tadashinagashima/certificadora-dois/hardware/mecanica/exportacoes/prancha_dimensional.pdf

# TABULEIRO DE XADREZ SENSORIAL

MEC-01 / Estudo dimensional paramétrico - unidades em mm - configuração inicial de protótipo

## A. MDF SUPERIOR SEM VIDRO / PLANTA

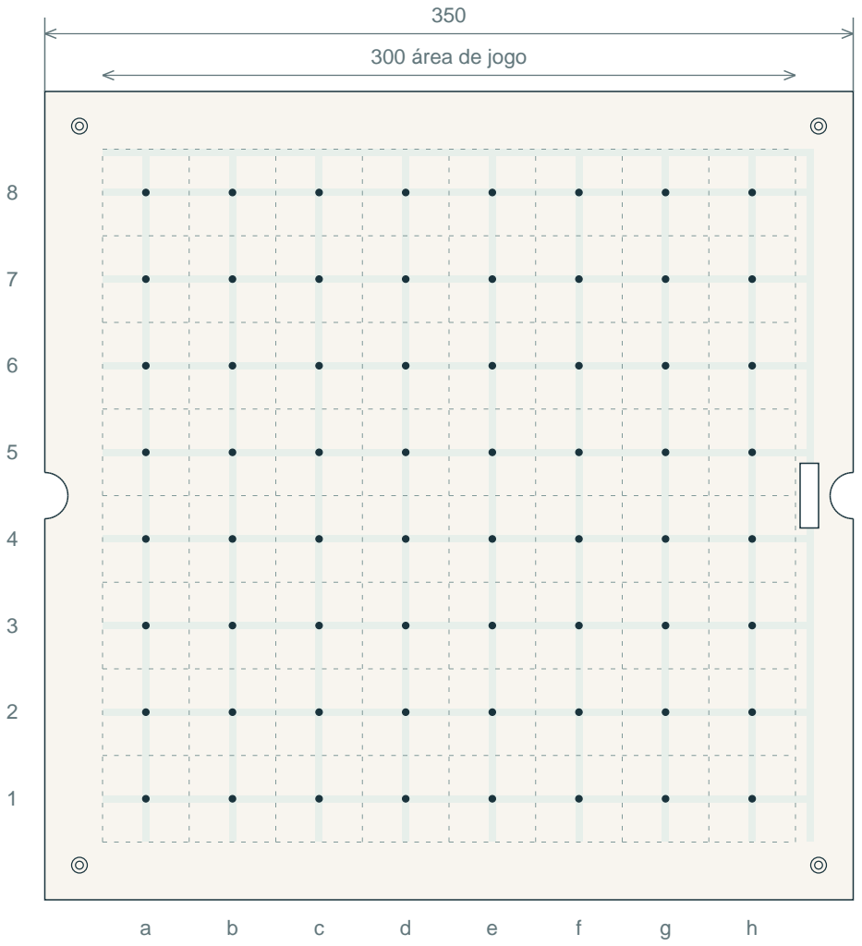
[picture p1: figure]
300 área de jogo

LADO DAS BRANCAS / Y MÍNIMO

350

64 × Ø2,8 passantes

Eixos: 43,75 + n × 37,5
n = 0...7, nos eixos X e Y.

### 16 canais 3 × 2 + 2 coletores

Fios isolados e soldas abaixo do apoio. Cruzamentos: isolar redes distintas.

Saída do chicote: 8 × 28

X = 327...335 / Y = 161...189

4 × Ø3,4 + escareado Ø6,8

Escareado 90° / profundidade 1,7 Centros 15 mm de cada borda.

### 2 pegas laterais R10 no suporte

Centro Y = 175; vidro continua inteiro.

A1 = (43,75; 43,75)
H8 = (306,25; 306,25)

## B. DETALHE DE UMA CASA / CORTE

Ímã ferrite Ø12 × 3

Vidro 3
Canal 3 × 2
MDF 6
Cola quente inferior

Reed vertical Ø2 × 14 (hipótese)

3

Distância vidro / topo do corpo = 3.
Centro do corpo 10 abaixo do vidro.
Local do contato e campo magnético NÃO simulados. Folga placa / terminal reto = 7; confirmar soldas/cabos. Ensaio obrigatório de uma casa antes de repetir 64.

## C. FRENTE E ACESSOS

60

Botões Ø12: X=65 / 175 / 285; LEDs Ø5: X=115 / 235.
Centro Z=28. Abertura lateral direita 70 × 20; origem Y=140, Z=9.

ESTRUTURA / COTAS VERTICAIS

Fundo 6; paredes 9; suporte superior 6; junta instalada 1; vidro 3.
Altura da caixa 60; altura com pés 63. Travessa central entre colunas d/e.
Vidro nominal350 ×350: confirmar a dimensão real da peça já disponível.
Fixação com cabeça embutida; confirmar parafuso, comprimento e resistência do MDF.

### ESTUDO DE PROTÓTIPO - NÃO LIBERADO PARA FABRICAÇÃO

Validado por software: sólidos, interferências dos envelopes e recomputação paramétrica. Não valida rigidez, tolerâncias nem acionamento magnético.

A3 / 01

Sem escala de impressão garantida
