tadashinagashima/certificadora-dois/hardware/mecanica/exportacoes/coordenadas_sensores.csv

casa | coluna | linha | x_mm | y_mm | z_eixo_mm | eixo_reed
a1 | 0 | 0 | 43.75 | 43.75 | 47.0 | Z
b1 | 1 | 0 | 81.25 | 43.75 | 47.0 | Z
c1 | 2 | 0 | 118.75 | 43.75 | 47.0 | Z
d1 | 3 | 0 | 156.25 | 43.75 | 47.0 | Z
e1 | 4 | 0 | 193.75 | 43.75 | 47.0 | Z
f1 | 5 | 0 | 231.25 | 43.75 | 47.0 | Z
g1 | 6 | 0 | 268.75 | 43.75 | 47.0 | Z
h1 | 7 | 0 | 306.25 | 43.75 | 47.0 | Z
a2 | 0 | 1 | 43.75 | 81.25 | 47.0 | Z
b2 | 1 | 1 | 81.25 | 81.25 | 47.0 | Z
c2 | 2 | 1 | 118.75 | 81.25 | 47.0 | Z
d2 | 3 | 1 | 156.25 | 81.25 | 47.0 | Z
e2 | 4 | 1 | 193.75 | 81.25 | 47.0 | Z
f2 | 5 | 1 | 231.25 | 81.25 | 47.0 | Z
g2 | 6 | 1 | 268.75 | 81.25 | 47.0 | Z
h2 | 7 | 1 | 306.25 | 81.25 | 47.0 | Z
a3 | 0 | 2 | 43.75 | 118.75 | 47.0 | Z
b3 | 1 | 2 | 81.25 | 118.75 | 47.0 | Z
c3 | 2 | 2 | 118.75 | 118.75 | 47.0 | Z
d3 | 3 | 2 | 156.25 | 118.75 | 47.0 | Z
e3 | 4 | 2 | 193.75 | 118.75 | 47.0 | Z
f3 | 5 | 2 | 231.25 | 118.75 | 47.0 | Z
g3 | 6 | 2 | 268.75 | 118.75 | 47.0 | Z
h3 | 7 | 2 | 306.25 | 118.75 | 47.0 | Z
a4 | 0 | 3 | 43.75 | 156.25 | 47.0 | Z
b4 | 1 | 3 | 81.25 | 156.25 | 47.0 | Z
c4 | 2 | 3 | 118.75 | 156.25 | 47.0 | Z
d4 | 3 | 3 | 156.25 | 156.25 | 47.0 | Z
e4 | 4 | 3 | 193.75 | 156.25 | 47.0 | Z
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
