tadashinagashima/certificadora-dois/hardware/eletronica/exports/preview-1.png

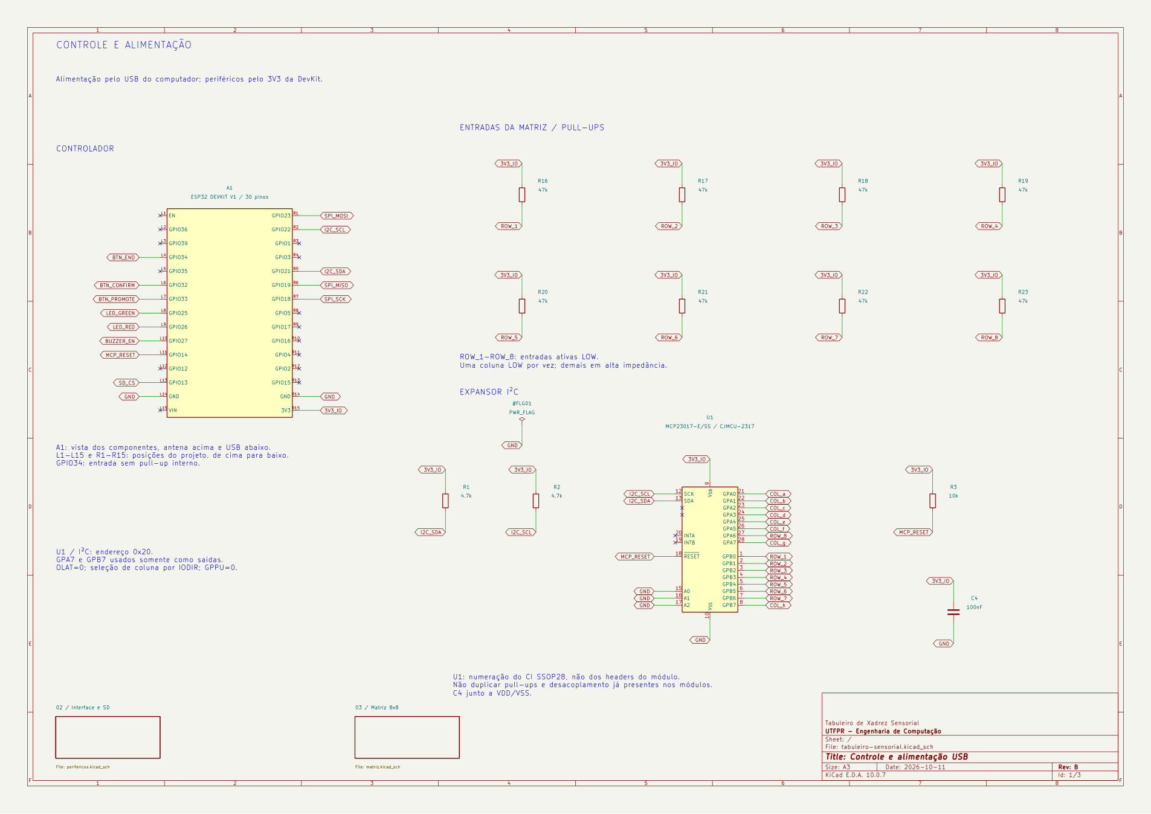
hardware/eletronica/exports/preview-1.png
