tadashinagashima/certificadora-dois/hardware/eletronica/exports/preview-2.png

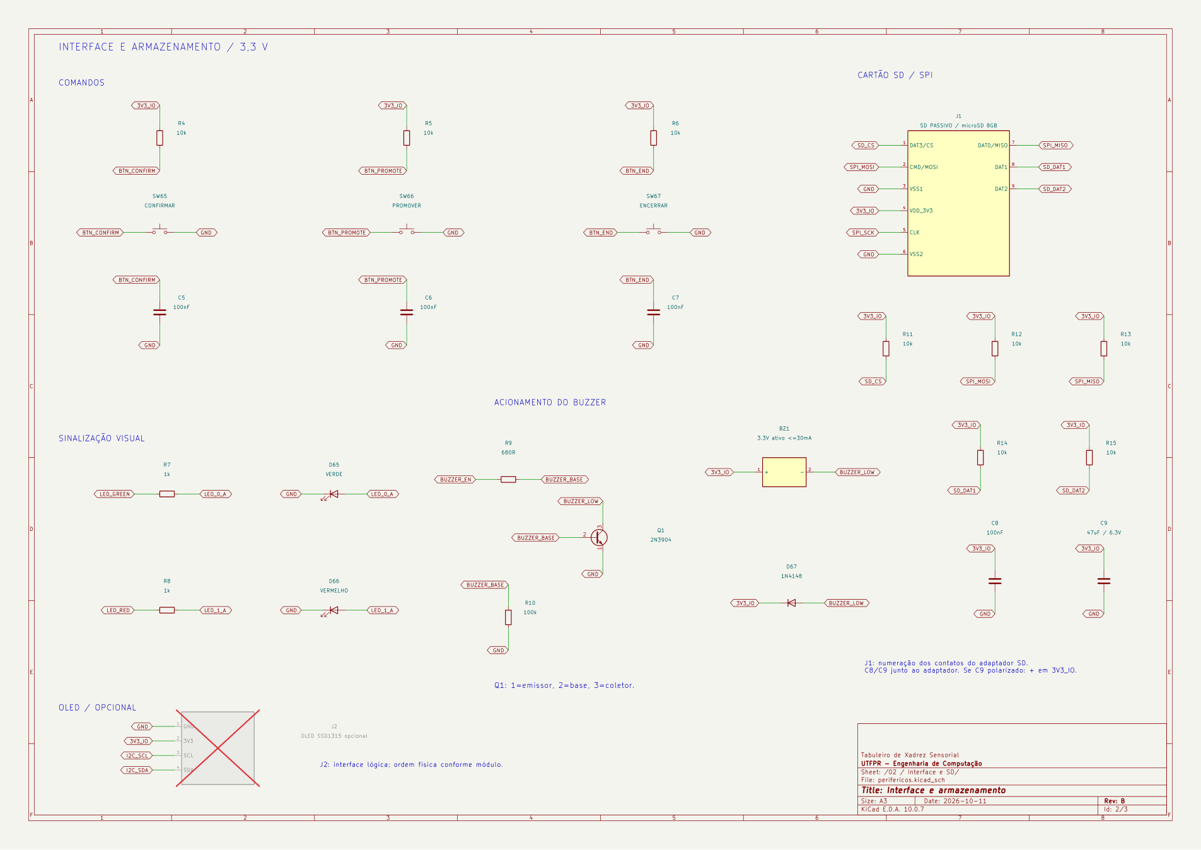
hardware/eletronica/exports/preview-2.png
