tadashinagashima/certificadora-dois/hardware/eletronica/exports/preview-3.png

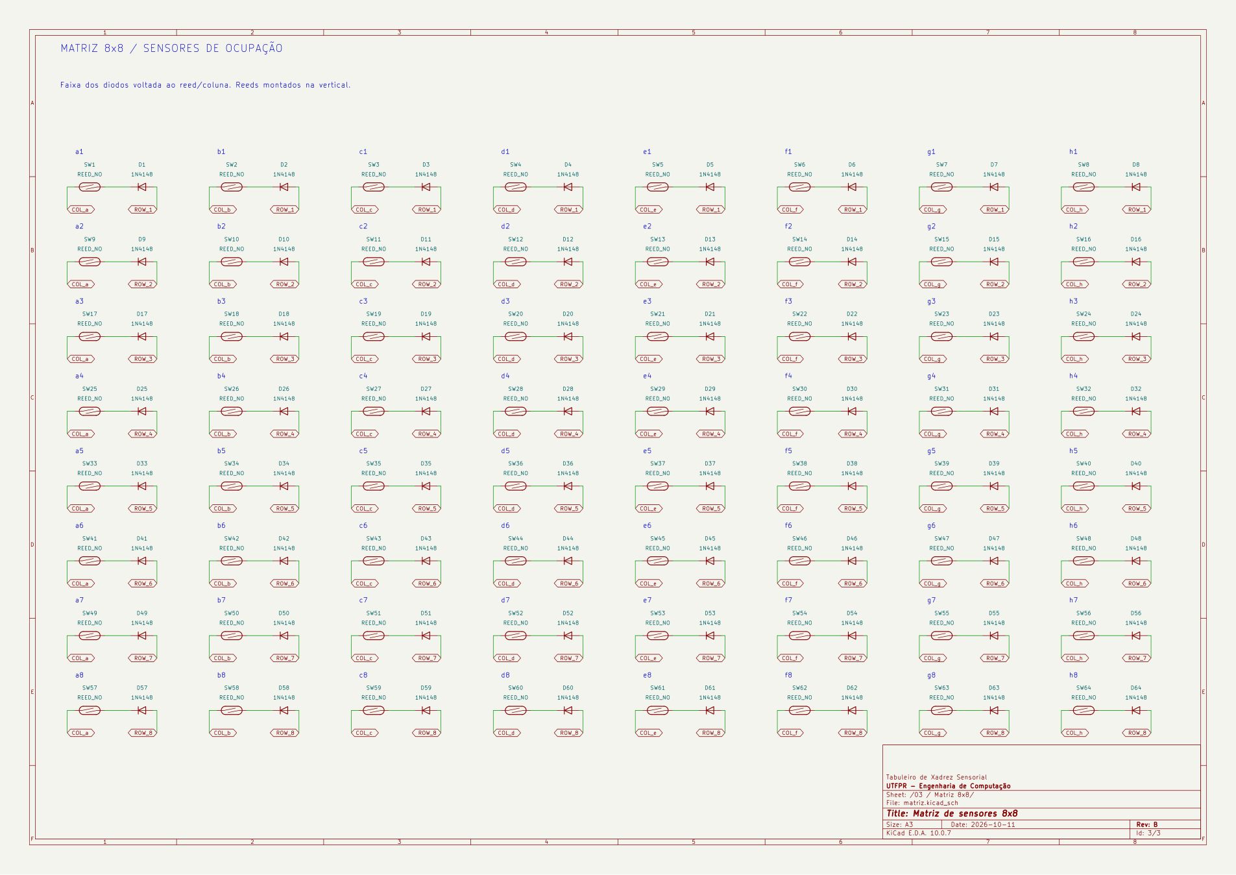
hardware/eletronica/exports/preview-3.png
