tadashinagashima/certificadora-dois/hardware/mecanica/exportacoes/matriz_inferior.png

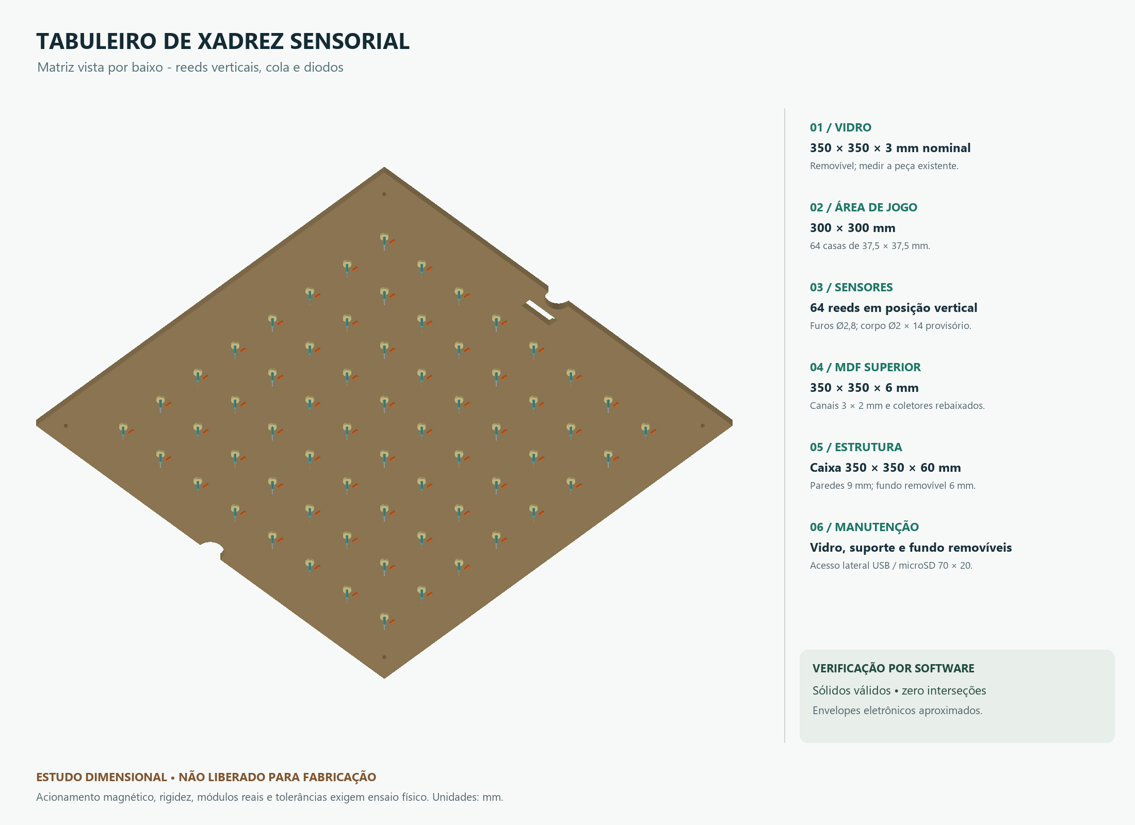
hardware/mecanica/exportacoes/matriz_inferior.png
