tadashinagashima/certificadora-dois/hardware/mecanica/exportacoes/vista_explodida.png

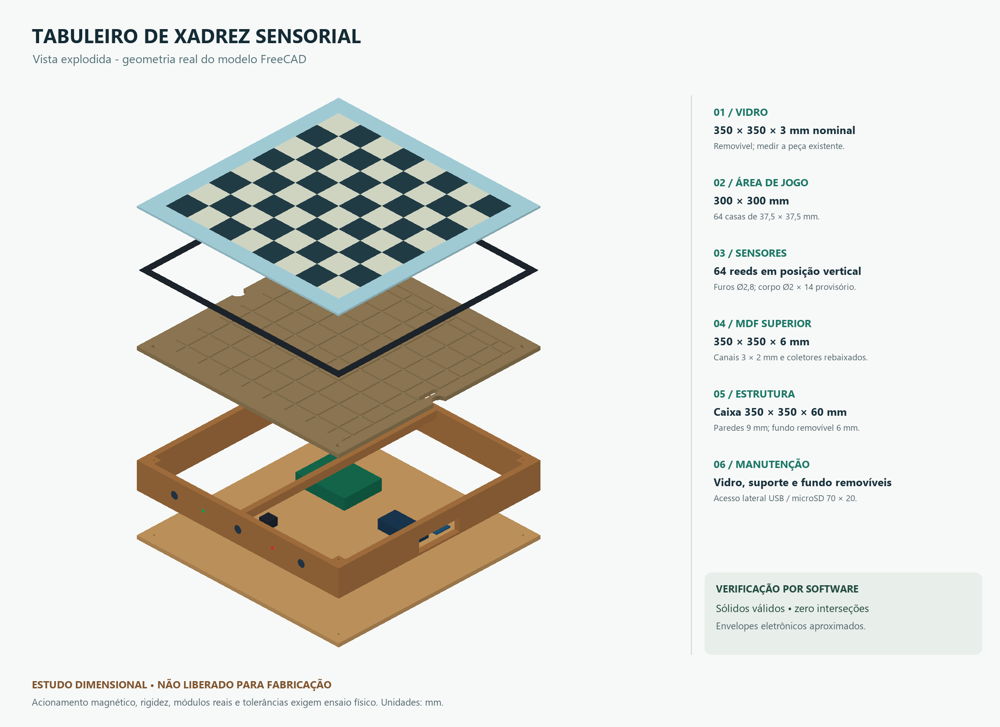
hardware/mecanica/exportacoes/vista_explodida.png
