tadashinagashima/certificadora-dois/hardware/eletronica/exports/bom.csv

Refs | Value | Footprint | Qty | DNP
A1 | ESP32 DEVKIT V1 / 30 pinos |  | 1
BZ1 | 3.3V ativo <=30mA |  | 1
C4 | 100nF |  | 1
C5 | 100nF |  | 1
C6 | 100nF |  | 1
C7 | 100nF |  | 1
C8 | 100nF |  | 1
C9 | 47uF / 6.3V |  | 1
D1 | 1N4148 |  | 1
D2 | 1N4148 |  | 1
D3 | 1N4148 |  | 1
D4 | 1N4148 |  | 1
D5 | 1N4148 |  | 1
D6 | 1N4148 |  | 1
D7 | 1N4148 |  | 1
D8 | 1N4148 |  | 1
D9 | 1N4148 |  | 1
D10 | 1N4148 |  | 1
D11 | 1N4148 |  | 1
D12 | 1N4148 |  | 1
D13 | 1N4148 |  | 1
D14 | 1N4148 |  | 1
D15 | 1N4148 |  | 1
D16 | 1N4148 |  | 1
D17 | 1N4148 |  | 1
D18 | 1N4148 |  | 1
D19 | 1N4148 |  | 1
D20 | 1N4148 |  | 1
D21 | 1N4148 |  | 1
D22 | 1N4148 |  | 1
D23 | 1N4148 |  | 1
D24 | 1N4148 |  | 1
D25 | 1N4148 |  | 1
D26 | 1N4148 |  | 1
D27 | 1N4148 |  | 1
D28 | 1N4148 |  | 1
D29 | 1N4148 |  | 1
D30 | 1N4148 |  | 1
D31 | 1N4148 |  | 1
D32 | 1N4148 |  | 1
D33 | 1N4148 |  | 1
D34 | 1N4148 |  | 1
D35 | 1N4148 |  | 1
D36 | 1N4148 |  | 1
D37 | 1N4148 |  | 1
D38 | 1N4148 |  | 1
D39 | 1N4148 |  | 1
D40 | 1N4148 |  | 1
D41 | 1N4148 |  | 1
D42 | 1N4148 |  | 1
D43 | 1N4148 |  | 1
D44 | 1N4148 |  | 1
D45 | 1N4148 |  | 1
D46 | 1N4148 |  | 1
D47 | 1N4148 |  | 1
D48 | 1N4148 |  | 1
D49 | 1N4148 |  | 1
D50 | 1N4148 |  | 1
D51 | 1N4148 |  | 1
D52 | 1N4148 |  | 1
D53 | 1N4148 |  | 1
D54 | 1N4148 |  | 1
D55 | 1N4148 |  | 1
D56 | 1N4148 |  | 1
D57 | 1N4148 |  | 1
D58 | 1N4148 |  | 1
D59 | 1N4148 |  | 1
D60 | 1N4148 |  | 1
D61 | 1N4148 |  | 1
D62 | 1N4148 |  | 1
D63 | 1N4148 |  | 1
D64 | 1N4148 |  | 1
D65 | VERDE |  | 1
D66 | VERMELHO |  | 1
D67 | 1N4148 |  | 1
J1 | SD PASSIVO / microSD 8GB |  | 1
J2 | OLED SSD1315 opcional |  | 1 | DNP
Q1 | 2N3904 | Package_TO_SOT_THT:TO-92_Inline | 1
R1 | 4.7k |  | 1
R2 | 4.7k |  | 1
R3 | 10k |  | 1
R4 | 10k |  | 1
R5 | 10k |  | 1
R6 | 10k |  | 1
R7 | 1k |  | 1
R8 | 1k |  | 1
R9 | 680R |  | 1
R10 | 100k |  | 1
R11 | 10k |  | 1
R12 | 10k |  | 1
R13 | 10k |  | 1
R14 | 10k |  | 1
R15 | 10k |  | 1
R16 | 47k |  | 1
R17 | 47k |  | 1
R18 | 47k |  | 1
R19 | 47k |  | 1
R20 | 47k |  | 1
R21 | 47k |  | 1
R22 | 47k |  | 1
R23 | 47k |  | 1
SW1 | REED_NO |  | 1
SW2 | REED_NO |  | 1
SW3 | REED_NO |  | 1
SW4 | REED_NO |  | 1
SW5 | REED_NO |  | 1
SW6 | REED_NO |  | 1
SW7 | REED_NO |  | 1
SW8 | REED_NO |  | 1
SW9 | REED_NO |  | 1
SW10 | REED_NO |  | 1
SW11 | REED_NO |  | 1
SW12 | REED_NO |  | 1
SW13 | REED_NO |  | 1
SW14 | REED_NO |  | 1
SW15 | REED_NO |  | 1
SW16 | REED_NO |  | 1
SW17 | REED_NO |  | 1
SW18 | REED_NO |  | 1
SW19 | REED_NO |  | 1
SW20 | REED_NO |  | 1
SW21 | REED_NO |  | 1
SW22 | REED_NO |  | 1
SW23 | REED_NO |  | 1
SW24 | REED_NO |  | 1
SW25 | REED_NO |  | 1
SW26 | REED_NO |  | 1
SW27 | REED_NO |  | 1
SW28 | REED_NO |  | 1
SW29 | REED_NO |  | 1
SW30 | REED_NO |  | 1
SW31 | REED_NO |  | 1
SW32 | REED_NO |  | 1
SW33 | REED_NO |  | 1
SW34 | REED_NO |  | 1
SW35 | REED_NO |  | 1
SW36 | REED_NO |  | 1
SW37 | REED_NO |  | 1
SW38 | REED_NO |  | 1
SW39 | REED_NO |  | 1
SW40 | REED_NO |  | 1
SW41 | REED_NO |  | 1
SW42 | REED_NO |  | 1
SW43 | REED_NO |  | 1
SW44 | REED_NO |  | 1
SW45 | REED_NO |  | 1
SW46 | REED_NO |  | 1
SW47 | REED_NO |  | 1
SW48 | REED_NO |  | 1
SW49 | REED_NO |  | 1
SW50 | REED_NO |  | 1
SW51 | REED_NO |  | 1
SW52 | REED_NO |  | 1
SW53 | REED_NO |  | 1
SW54 | REED_NO |  | 1
SW55 | REED_NO |  | 1
SW56 | REED_NO |  | 1
SW57 | REED_NO |  | 1
SW58 | REED_NO |  | 1
SW59 | REED_NO |  | 1
SW60 | REED_NO |  | 1
SW61 | REED_NO |  | 1
SW62 | REED_NO |  | 1
SW63 | REED_NO |  | 1
SW64 | REED_NO |  | 1
SW65 | CONFIRMAR |  | 1
SW66 | PROMOVER |  | 1
SW67 | ENCERRAR |  | 1
U1 | MCP23017-E/SS / CJMCU-2317 |  | 1
