tadashinagashima/certificadora-dois/hardware/mecanica/exportacoes/tabuleiro_sensorial.step

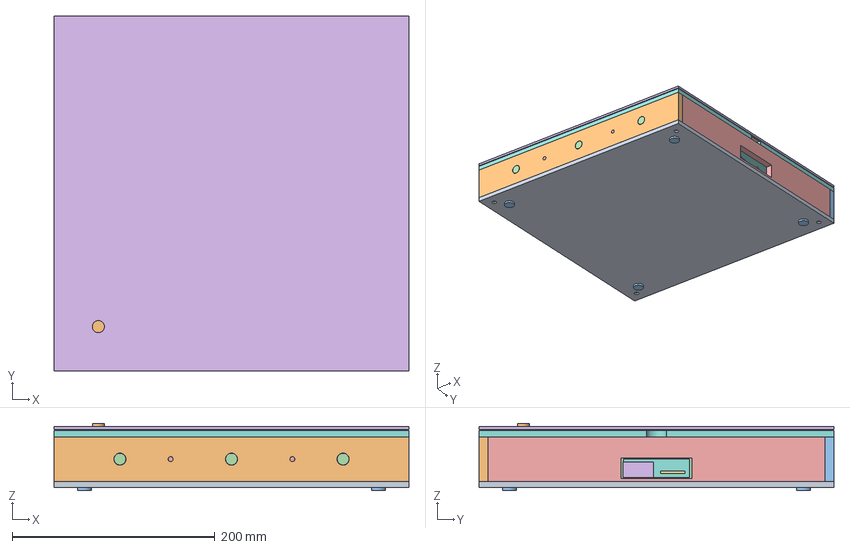
[picture p7: CAD file, 2026-10-12]
hardware/mecanica/exportacoes/tabuleiro_sensorial.step
350.0 x 350.0 x 66.2 mm
M01 | Fundo MDF 6 mm - removivel
M02 | Frente - 3 botoes e 2 LEDs
M03 | Traseira MDF 9 mm
M04 | Lateral esquerda MDF 9 mm
M05 | Lateral direita - acesso 70 x 20 USB / microSD
V01 | Vidro 3 mm removivel - bordas lapidadas
J01 | Junta periferica 10 mm - apoio vidro
M06 | MDF 6 mm - 64 furos, 16 canais e pegas
M07 | Travessa central de apoio - entre colunas d/e
A01 | Apoio 12 x 12 - furos piloto
P01 | Pe elastomerico
A02 | Apoio 12 x 12 - furos piloto
P02 | Pe elastomerico
A03 | Apoio 12 x 12 - furos piloto
P03 | Pe elastomerico
A04 | Apoio 12 x 12 - furos piloto
P04 | Pe elastomerico
REF | Botao CONFIRMAR
REF | Botao PROMOCAO
REF | Botao ENCERRAR
REF | LED 1
REF | LED 2
REF | ESP32 / USB - envelope generico
REF | adaptador SD passivo / microSD - envelope
REF | placa MCP23017 / interfaces - reserva
REF | buzzer - reserva
REF | Ima ferrite 12 x 3 - exemplo a1, folga feltro0.2 provisoria
S_a1 | Reed - envelope
S_a1 | Terminais retos - ilustrativos
D_a1 | 1N4148 - envelope
REF | Cola quente sob MDF a1
S_b1 | Reed - envelope
S_b1 | Terminais retos - ilustrativos
D_b1 | 1N4148 - envelope
REF | Cola quente sob MDF b1
S_c1 | Reed - envelope
S_c1 | Terminais retos - ilustrativos
D_c1 | 1N4148 - envelope
REF | Cola quente sob MDF c1
S_d1 | Reed - envelope
S_d1 | Terminais retos - ilustrativos
D_d1 | 1N4148 - envelope
REF | Cola quente sob MDF d1
S_e1 | Reed - envelope
S_e1 | Terminais retos - ilustrativos
D_e1 | 1N4148 - envelope
REF | Cola quente sob MDF e1
S_f1 | Reed - envelope
S_f1 | Terminais retos - ilustrativos
D_f1 | 1N4148 - envelope
REF | Cola quente sob MDF f1
S_g1 | Reed - envelope
S_g1 | Terminais retos - ilustrativos
D_g1 | 1N4148 - envelope
REF | Cola quente sob MDF g1
S_h1 | Reed - envelope
S_h1 | Terminais retos - ilustrativos
D_h1 | 1N4148 - envelope
REF | Cola quente sob MDF h1
S_a2 | Reed - envelope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
