tadashinagashima/certificadora-dois/hardware/mecanica/tabuleiro_sensorial.FCStd

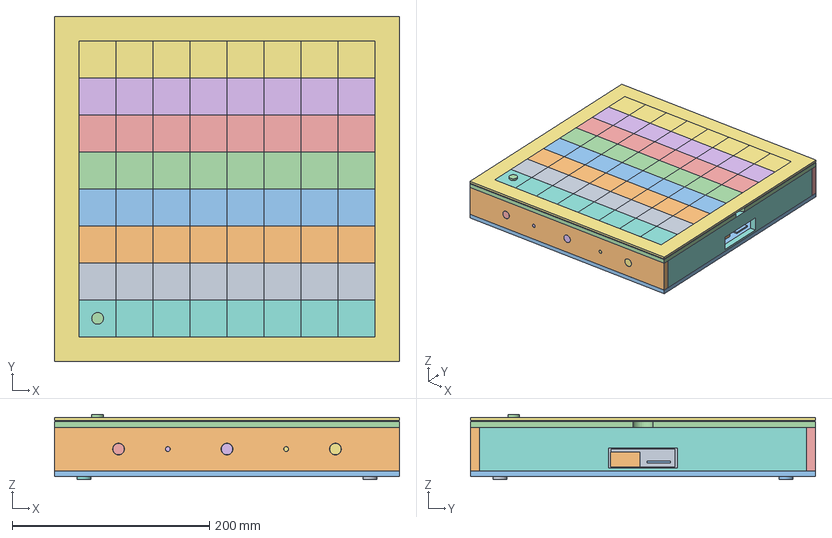
[picture p8: CAD file, 2026-10-12]
hardware/mecanica/tabuleiro_sensorial.FCStd
350.0 x 350.0 x 66.2 mm
A01 | Apoio 12 x 12 - furos piloto
A02 | Apoio 12 x 12 - furos piloto
A03 | Apoio 12 x 12 - furos piloto
A04 | Apoio 12 x 12 - furos piloto
REF | Botao CONFIRMAR
REF | Botao PROMOCAO
REF | Botao ENCERRAR
VISUAL | a1 - pintura ilustrativa
VISUAL | a2 - pintura ilustrativa
VISUAL | a3 - pintura ilustrativa
VISUAL | a4 - pintura ilustrativa
VISUAL | a5 - pintura ilustrativa
VISUAL | a6 - pintura ilustrativa
VISUAL | a7 - pintura ilustrativa
VISUAL | a8 - pintura ilustrativa
VISUAL | b1 - pintura ilustrativa
VISUAL | b2 - pintura ilustrativa
VISUAL | b3 - pintura ilustrativa
VISUAL | b4 - pintura ilustrativa
VISUAL | b5 - pintura ilustrativa
VISUAL | b6 - pintura ilustrativa
VISUAL | b7 - pintura ilustrativa
VISUAL | b8 - pintura ilustrativa
VISUAL | c1 - pintura ilustrativa
VISUAL | c2 - pintura ilustrativa
VISUAL | c3 - pintura ilustrativa
VISUAL | c4 - pintura ilustrativa
VISUAL | c5 - pintura ilustrativa
VISUAL | c6 - pintura ilustrativa
VISUAL | c7 - pintura ilustrativa
VISUAL | c8 - pintura ilustrativa
VISUAL | d1 - pintura ilustrativa
VISUAL | d2 - pintura ilustrativa
VISUAL | d3 - pintura ilustrativa
VISUAL | d4 - pintura ilustrativa
VISUAL | d5 - pintura ilustrativa
VISUAL | d6 - pintura ilustrativa
VISUAL | d7 - pintura ilustrativa
VISUAL | d8 - pintura ilustrativa
VISUAL | e1 - pintura ilustrativa
VISUAL | e2 - pintura ilustrativa
VISUAL | e3 - pintura ilustrativa
VISUAL | e4 - pintura ilustrativa
VISUAL | e5 - pintura ilustrativa
VISUAL | e6 - pintura ilustrativa
VISUAL | e7 - pintura ilustrativa
VISUAL | e8 - pintura ilustrativa
VISUAL | f1 - pintura ilustrativa
VISUAL | f2 - pintura ilustrativa
VISUAL | f3 - pintura ilustrativa
VISUAL | f4 - pintura ilustrativa
VISUAL | f5 - pintura ilustrativa
VISUAL | f6 - pintura ilustrativa
VISUAL | f7 - pintura ilustrativa
VISUAL | f8 - pintura ilustrativa
VISUAL | g1 - pintura ilustrativa
VISUAL | g2 - pintura ilustrativa
VISUAL | g3 - pintura ilustrativa
VISUAL | g4 - pintura ilustrativa
VISUAL | g5 - pintura ilustrativa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
