tadashinagashima/certificadora-dois/hardware/mecanica/exportacoes/montagem.png

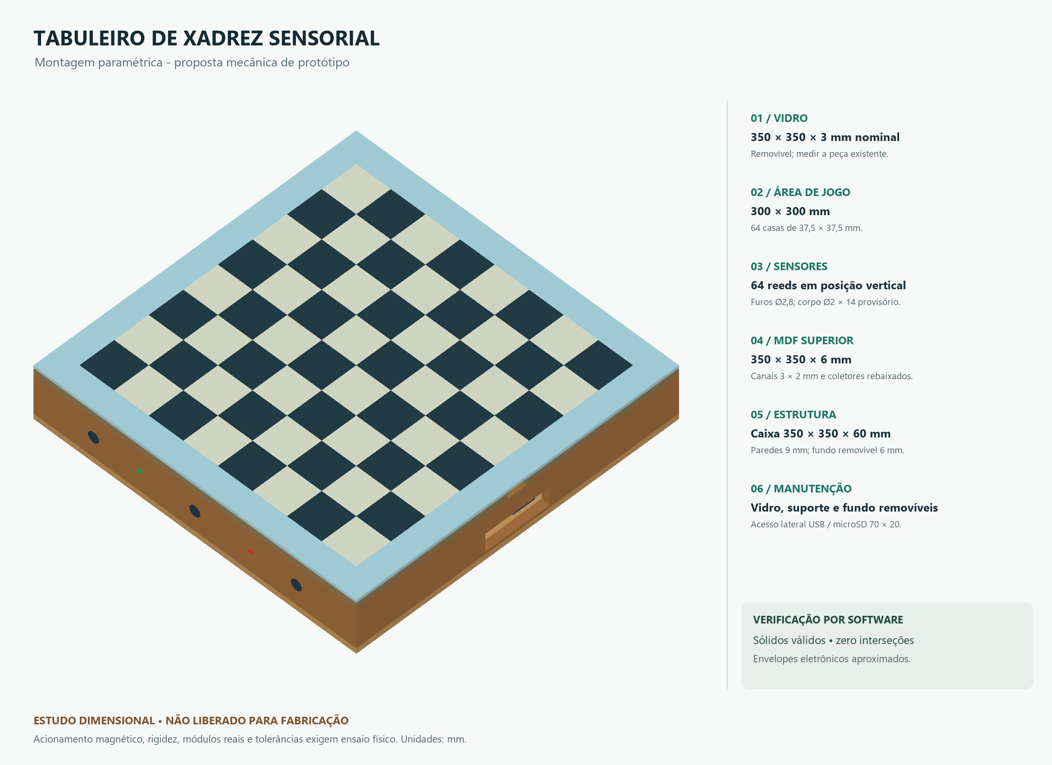
hardware/mecanica/exportacoes/montagem.png
