tadashinagashima/certificadora-dois/hardware/eletronica/perifericos.kicad_sch

## KiCad design hardware/eletronica/perifericos.kicad_sch (2026-10-12)

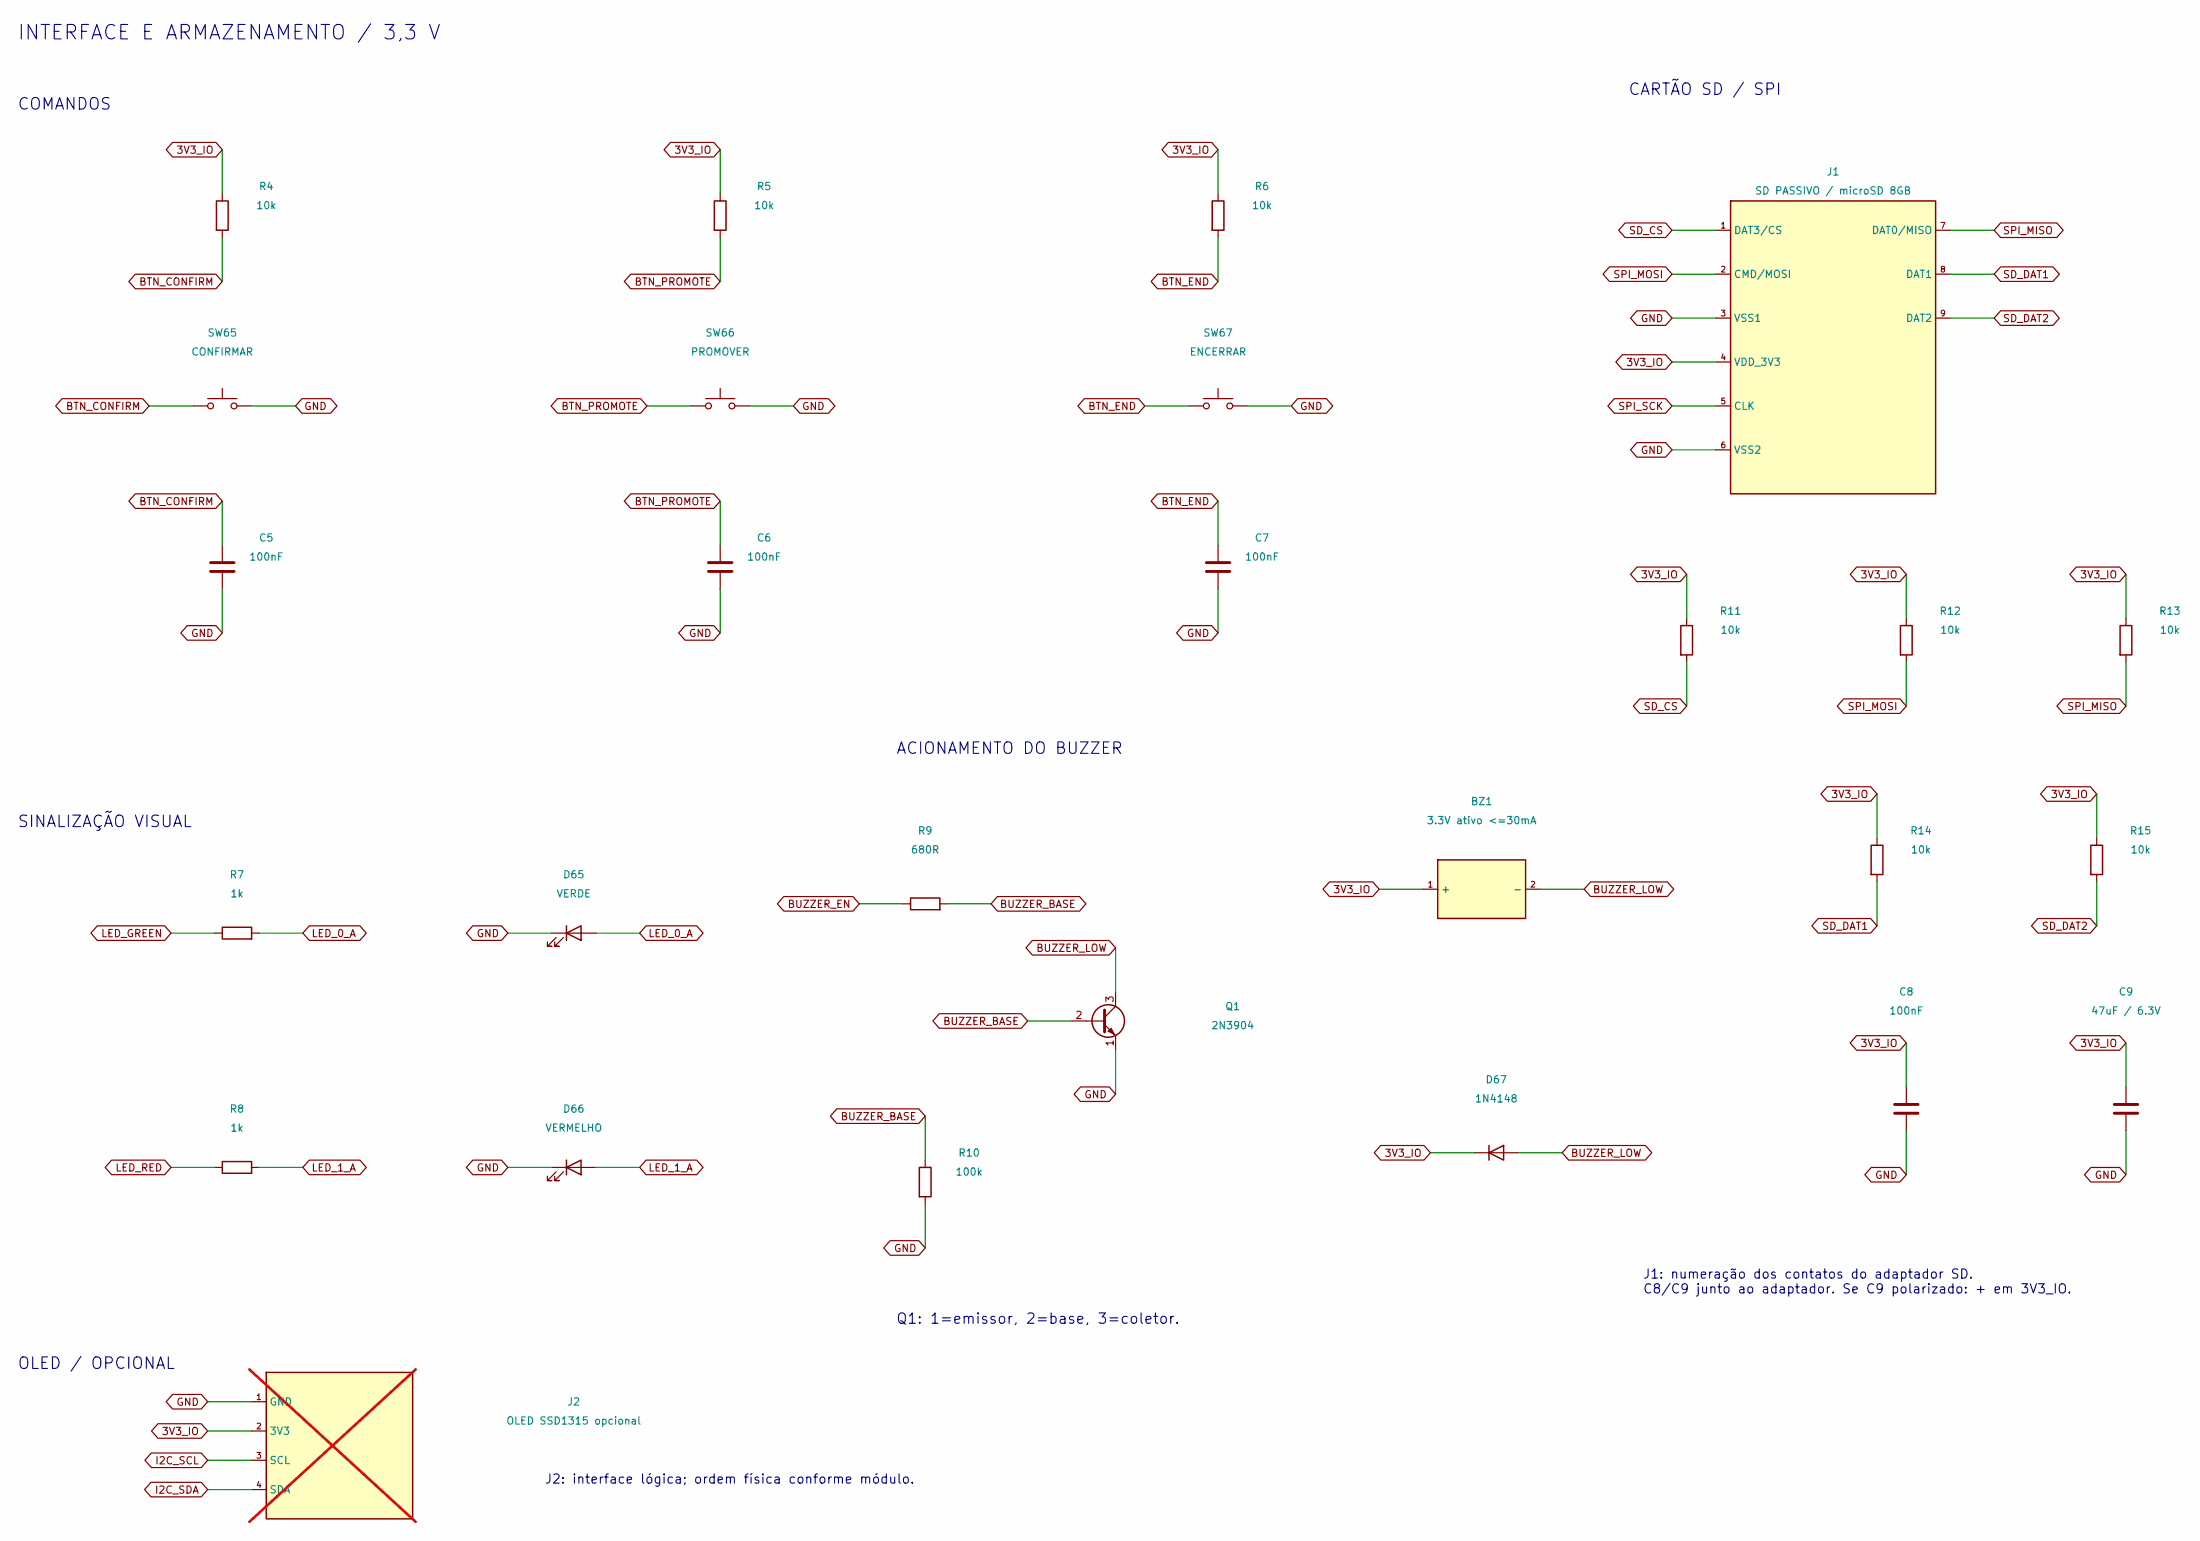
[picture p14: schematic perifericos.kicad_sch]

Parts:
BZ1: 3.3V ativo <=30mA
C5, C6, C7, C8: 100nF
C9: 47uF / 6.3V
D65: VERDE
D66: VERMELHO
D67: 1N4148
J1: SD PASSIVO / microSD 8GB
J2: OLED SSD1315 opcional; not fitted
Q1: 2N3904; TO-92_Inline
R4, R5, R6, R11, R12, R13, R14, R15: 10k
R7, R8: 1k
R9: 680R
R10: 100k
SW65: CONFIRMAR
SW66: PROMOVER
SW67: ENCERRAR

Connections:
3V3_IO: BZ1.1 (+), C8.1, C9.1, D67.1 (K), J1.4 (VDD_3V3), J2.2 (3V3), R4.1, R5.1, R6.1, R11.1, R12.1, R13.1, R14.1, R15.1
BTN_CONFIRM: C5.1, R4.2, SW65.1
BTN_END: C7.1, R6.2, SW67.1
BTN_PROMOTE: C6.1, R5.2, SW66.1
BUZZER_BASE: Q1.2 (B), R9.2, R10.1
BUZZER_EN: R9.1
BUZZER_LOW: BZ1.2 (-), D67.2 (A), Q1.3 (C)
GND: C5.2, C6.2, C7.2, C8.2, C9.2, D65.1 (K), D66.1 (K), J1.3 (VSS1), J1.6 (VSS2), J2.1 (GND), Q1.1 (E), R10.2, SW65.2, SW66.2, SW67.2
I2C_SCL: J2.3 (SCL)
I2C_SDA: J2.4 (SDA)
LED_0_A: D65.2 (A), R7.2
LED_1_A: D66.2 (A), R8.2
LED_GREEN: R7.1
LED_RED: R8.1
SD_CS: J1.1 (DAT3/CS), R11.2
SD_DAT1: J1.8 (DAT1), R14.2
SD_DAT2: J1.9 (DAT2), R15.2
SPI_MISO: J1.7 (DAT0/MISO), R13.2
SPI_MOSI: J1.2 (CMD/MOSI), R12.2
SPI_SCK: J1.5 (CLK)

Notes on the sheet:
INTERFACE E ARMAZENAMENTO / 3,3 V
COMANDOS
CARTÃO SD / SPI
SINALIZAÇÃO VISUAL
ACIONAMENTO DO BUZZER
Q1: 1=emissor, 2=base, 3=coletor.
J1: numeração dos contatos do adaptador SD. C8/C9 junto ao adaptador. Se C9 polarizado: + em 3V3_IO.
OLED / OPCIONAL
J2: interface lógica; ordem física conforme módulo.
