tadashinagashima/certificadora-dois/hardware/eletronica/tabuleiro-sensorial.kicad_sch

## KiCad design hardware/eletronica/tabuleiro-sensorial.kicad_sch (2026-10-12)

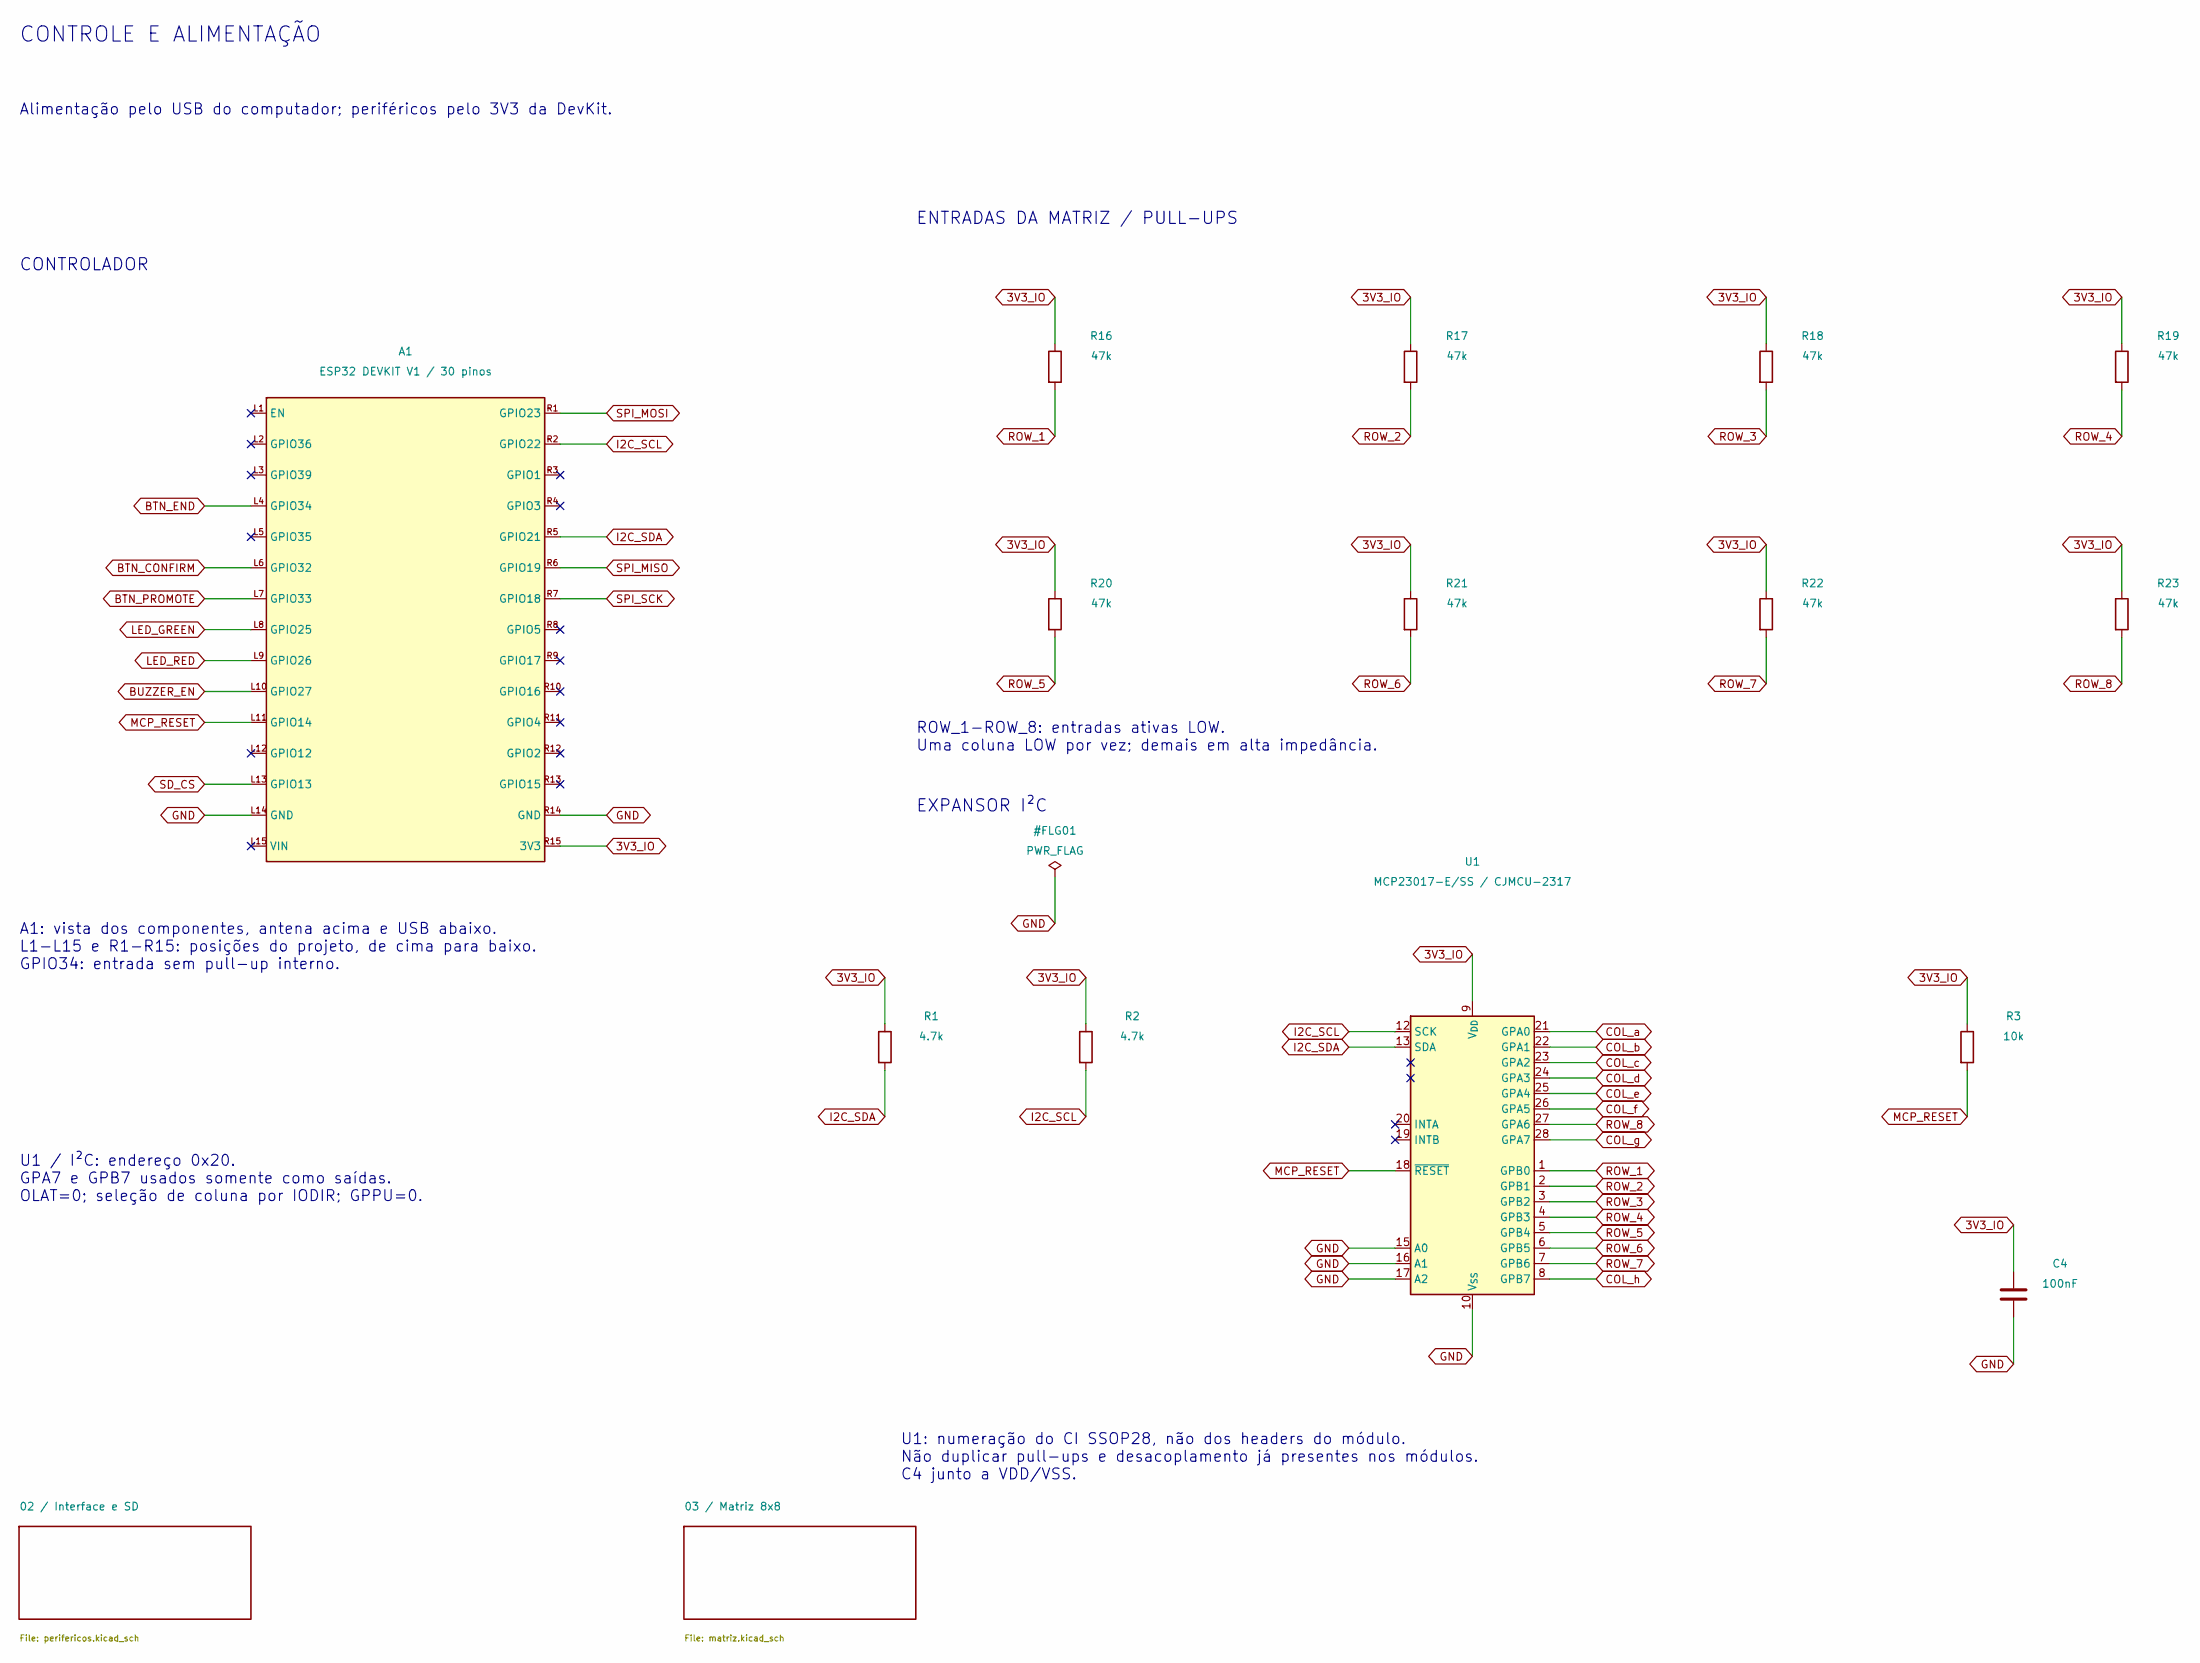
[picture p15: schematic tabuleiro-sensorial.kicad_sch]

Parts:
A1: ESP32 DEVKIT V1 / 30 pinos
C4: 100nF
R1, R2: 4.7k
R3: 10k
R16, R17, R18, R19, R20, R21, R22, R23: 47k
U1: MCP23017-E/SS / CJMCU-2317

Connections:
3V3_IO: A1.R15 (3V3), C4.1, R1.1, R2.1, R3.1, R16.1, R17.1, R18.1, R19.1, R20.1, R21.1, R22.1, R23.1, U1.9 (V_{DD})
BTN_CONFIRM: A1.L6 (GPIO32)
BTN_END: A1.L4 (GPIO34)
BTN_PROMOTE: A1.L7 (GPIO33)
BUZZER_EN: A1.L10 (GPIO27)
COL_a: U1.21 (GPA0)
COL_b: U1.22 (GPA1)
COL_c: U1.23 (GPA2)
COL_d: U1.24 (GPA3)
COL_e: U1.25 (GPA4)
COL_f: U1.26 (GPA5)
COL_g: U1.28 (GPA7)
COL_h: U1.8 (GPB7)
GND: A1.L14 (GND), A1.R14 (GND), C4.2, U1.10 (V_{SS}), U1.15 (A0), U1.16 (A1), U1.17 (A2)
I2C_SCL: A1.R2 (GPIO22), R2.2, U1.12 (SCK)
I2C_SDA: A1.R5 (GPIO21), R1.2, U1.13 (SDA)
LED_GREEN: A1.L8 (GPIO25)
LED_RED: A1.L9 (GPIO26)
MCP_RESET: A1.L11 (GPIO14), R3.2, U1.18 (~RESET)
ROW_1: R16.2, U1.1 (GPB0)
ROW_2: R17.2, U1.2 (GPB1)
ROW_3: R18.2, U1.3 (GPB2)
ROW_4: R19.2, U1.4 (GPB3)
ROW_5: R20.2, U1.5 (GPB4)
ROW_6: R21.2, U1.6 (GPB5)
ROW_7: R22.2, U1.7 (GPB6)
ROW_8: R23.2, U1.27 (GPA6)
SD_CS: A1.L13 (GPIO13)
SPI_MISO: A1.R6 (GPIO19)
SPI_MOSI: A1.R1 (GPIO23)
SPI_SCK: A1.R7 (GPIO18)

Notes on the sheet:
CONTROLE E ALIMENTAÇÃO
Alimentação pelo USB do computador; periféricos pelo 3V3 da DevKit.
CONTROLADOR
ENTRADAS DA MATRIZ / PULL-UPS
A1: vista dos componentes, antena acima e USB abaixo. L1-L15 e R1-R15: posições do projeto, de cima para baixo. GPIO34: entrada sem pull-up interno.
ROW_1-ROW_8: entradas ativas LOW. Uma coluna LOW por vez; demais em alta impedância.
EXPANSOR I²C
U1 / I²C: endereço 0x20. GPA7 e GPB7 usados somente como saídas. OLAT=0; seleção de coluna por IODIR; GPPU=0.
U1: numeração do CI SSOP28, não dos headers do módulo. Não duplicar pull-ups e desacoplamento já presentes nos módulos. C4 junto a VDD/VSS.
