tadashinagashima/certificadora-dois/(commit log)

2026-10-10 Update README with project information for chessboard
    Added project details for a sensory chessboard, including objectives, functionality, technologies, and team members.
2026-10-10 Add chessboard requirements spec
    This commit adds the project requirements document for the sensorial chessboard prototype. It defines the functional and non-functional requirements, implementation constraints, optional display, and validation points for the board, sensor detection, move validation, game state management, and PGN recording.
2026-10-10 Adicionar arquitetura do sistema
    Adiciona a documentação da arquitetura eletrônica do projeto, descrevendo o fluxo entre ESP32, MCP23017, matriz de Reed Switches, alimentação, LEDs, buzzer, SD e OLED opcional. Também registra a organização do firmware em módulos e o modelo de processamento das jogadas, com diagramas mermaid e SVG para apoiar a implementação e a validação do sistema.
2026-10-10 docs: adiciona diagramas UML de atividades e componentes
    - Adiciona diagramas UML de atividades e componentes em SVG.
    - Inclui o projeto editável do Astah.
    - Configura o .gitignore para excluir arquivos auxiliares e temporários da geração dos diagramas.
2026-10-12 feat: consolida projeto eletrônico e mecânico do tabuleiro sensorial
    - Atualiza requisitos, arquitetura e diagramas UML.
    - Adiciona esquemático KiCad revisão B para ESP32 DevKit V1.
    - Adiciona modelo mecânico paramétrico FreeCAD revisão A.
    - Documenta componentes, conexões e decisões técnicas.
    - Inclui exportações e verificações de consistência dos artefatos.
    Closes #1
2026-10-12 feat(firmware): implementa acompanhamento das jogadas
    - Adiciona MoveTracker independente do Arduino.
    - Registra alterações de ocupação por quadro.
    - Trata descarte, interrupções e limite do histórico.
    - Inclui testes automatizados e compilação para ESP32.
    - Documenta o contrato e a validação do módulo.
    Closes #2
2026-10-12 test(firmware): avalia bibliotecas de xadrez e seleciona THC
    - Avalia THC, htcw_chess e Disservin.
    - Adiciona testes funcionais das regras de xadrez.
    - Verifica compatibilidade e compilação para ESP32.
    - Registra limitações das alternativas avaliadas.
    - Documenta resultados e justificativa da seleção.
    Closes #3
2026-10-13 test(firmware): valida ChessAdapter e THC no ESP32 real
2026-10-13 Esclarecer o escopo de validação da biblioteca de xadrez
    Closes #4
2026-10-13 Add move interpretation module
    Introduz o módulo independente em C++ MoveInterpreter, que associa snapshots do tabuleiro a lances de xadrez válidos, incluindo o tratamento de promoções e ambiguidades. Também adiciona a documentação relacionada, metadados para CMake/Arduino, testes de regressão nativos e relatórios de validação para compilação nativa e para ESP32.
2026-10-13 Adicionar validação em tempo de execução para o MoveInterpreter no ESP32
    Documenta o fluxo de validação integrado para o MoveInterpreter e adiciona a sonda de tempo de execução para ESP32, o script coletor e as evidências de hardware para verificações de compilação, carregamento e execução. Ele registra resultados de benchmark, heap, stack e estabilidade na placa de destino, além da execução bem-sucedida da validação que confirma a viabilidade do interpretador no ESP32, preservando a cobertura da suíte de testes nativa.
2026-10-13 feat(firmware): implementa e valida controle da partida
    - Implementa GameController com confirmação, promoção, rejeição, retomada e encerramento da partida.
    - Integra logicamente MoveTracker, MoveInterpreter e ChessAdapter, preservando seus contratos.
    - Adiciona testes automatizados e atualiza a documentação e os diagramas UML.
    - Valida o Controle no ESP32 real: 93 testes nativos aprovados, 580 casos embarcados e 50.700 cenários sem falhas.
    - Registra medições de latência, heap, pilha e estabilidade, preservando as evidências de execução.
    Closes #7
2026-10-14 Add GameRecord SAN/PGN module
    Introduz o módulo GameRecord para capturar jogadas aceitas, gerar texto em notação SAN, exportar arquivos PGN com metadados/resultados e aplicar validações de contexto e capacidade. Isso inclui a nova API em C++, conjuntos de validação nativos e para ESP32, atualizações na documentação e a integração do fluxo de registro e PGN, sem alterar os contratos existentes de controle e lógica de xadrez.
